Tomas-Kuchta-FPV/FOSSwheel/Assets/readme.md

# 3D assets

## Sources
https://grabcad.com/library/6-5-hoverboard-hubmotor-wheel-1/details?folder_id=5329696
https://grabcad.com/library/hoverboard-mainboard-1  
https://grabcad.com/library/5-connectors-xt60-male-female-cable-and-panel-mount-1
https://makerworld.com/en/models/2341987-xt90-panel-mount-unisex
