Tomas-Kuchta-FPV/FOSSwheel/PCB/readme.md

# OSHW 2ch VESC board

## Desing consideration
- High voltage ~55V
- Medium current ~20A
- Powered by VESC
- 2 channel
- CAN
- IMU
- Current measurement

I have ran out of time so I'm switching to hoverboard ESCs with a custom FW or you can still use DIY cheap FOCer, as a middle ground of bought and maker style.
