Tomas-Kuchta-FPV/FOSSwheel/Assets/Capture.PNG

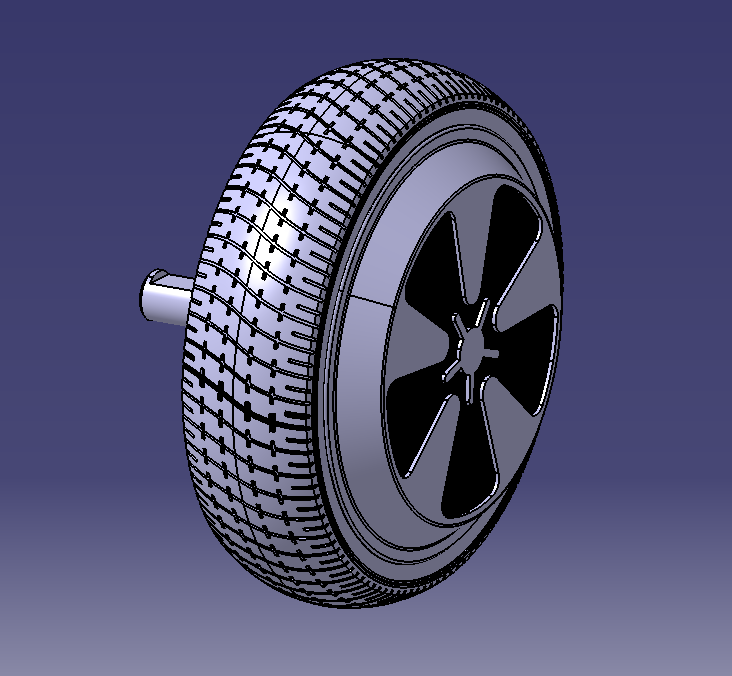
Assets/Capture.PNG
