Tomas-Kuchta-FPV/FOSSwheel/Cart/Aliexpress.png

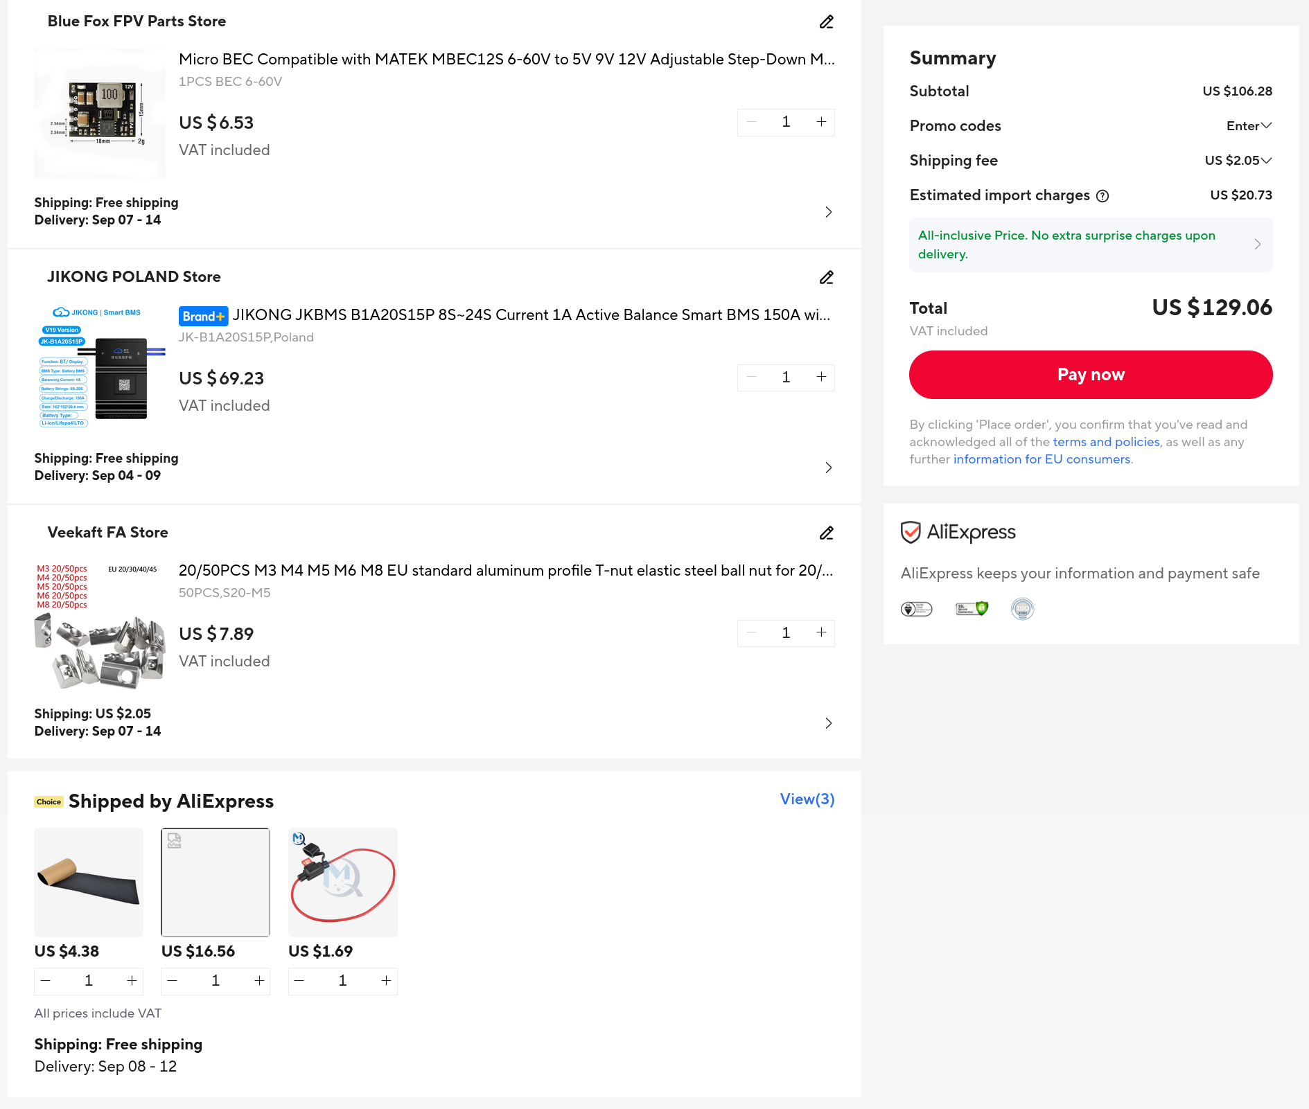
Cart/Aliexpress.png
