Tomas-Kuchta-FPV/FOSSwheel/Cart/big hobby.png

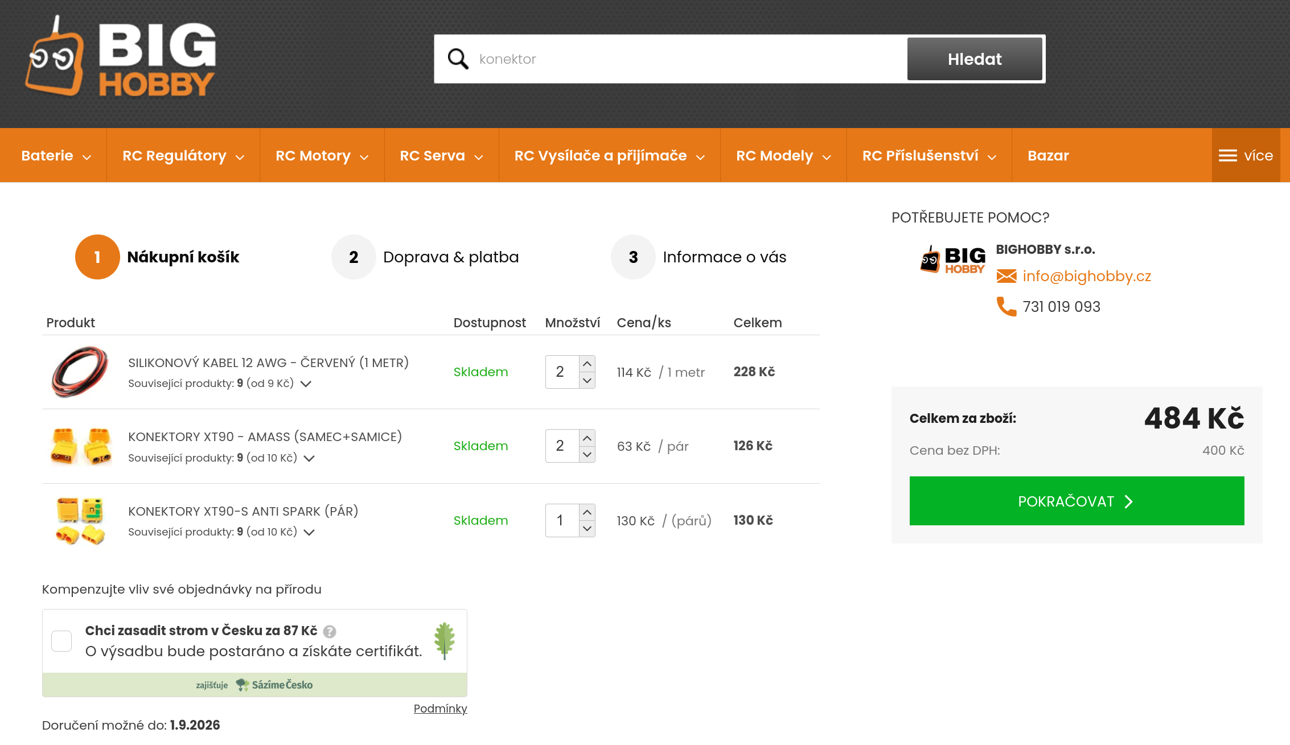
Cart/big hobby.png
