Tomas-Kuchta-FPV/FOSSwheel/Cart/ehlinik1.png

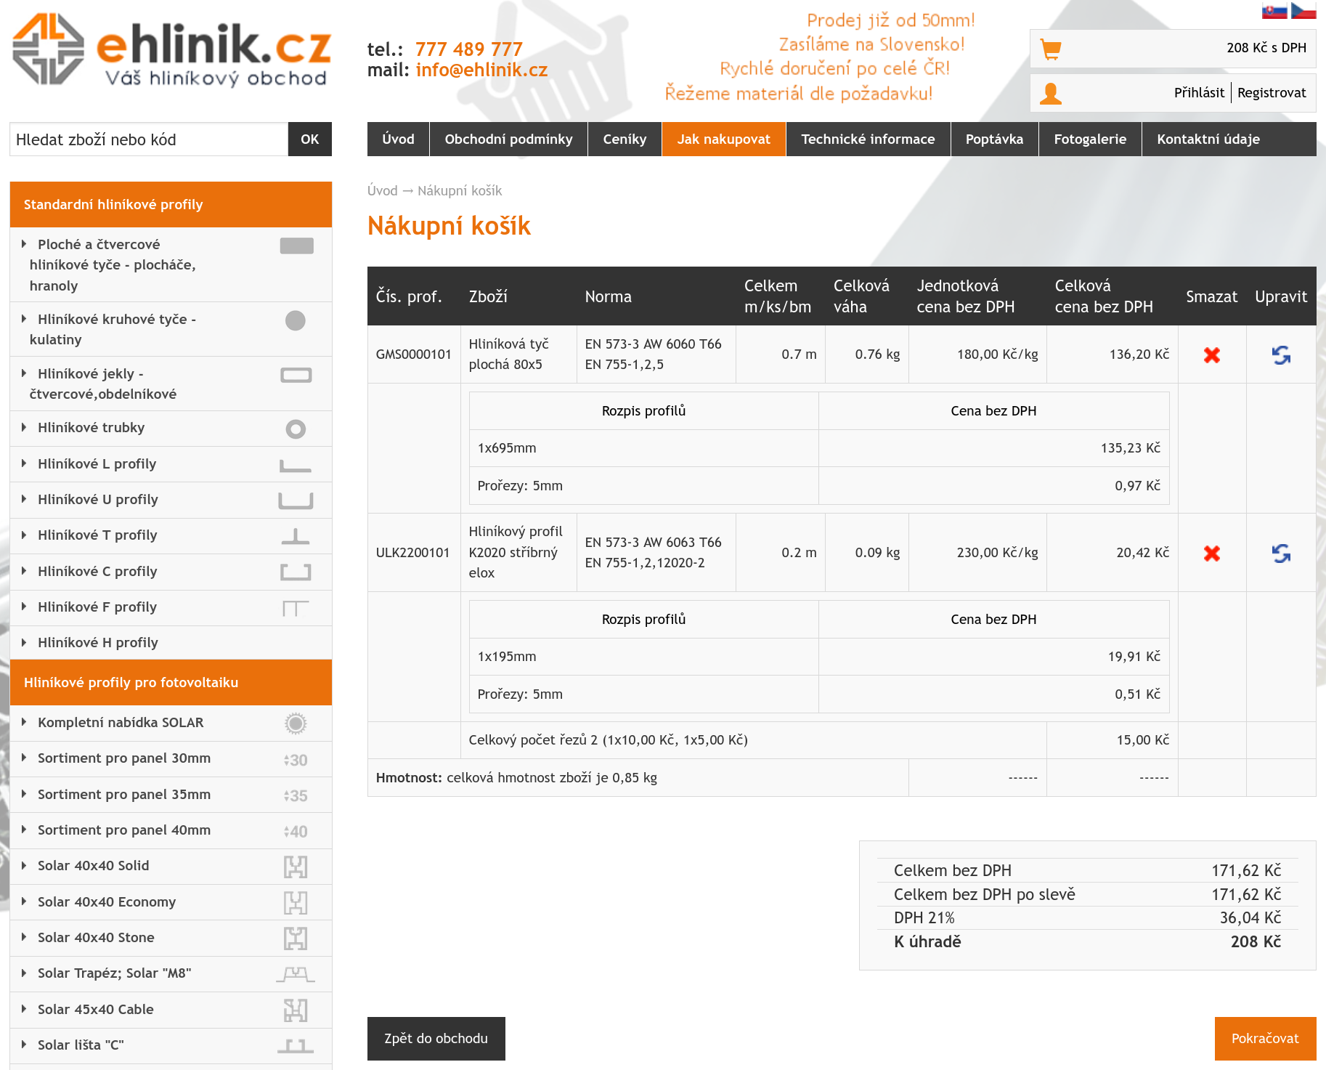
Cart/ehlinik1.png
