Tomas-Kuchta-FPV/FOSSwheel/Cart/ehlinik2.png

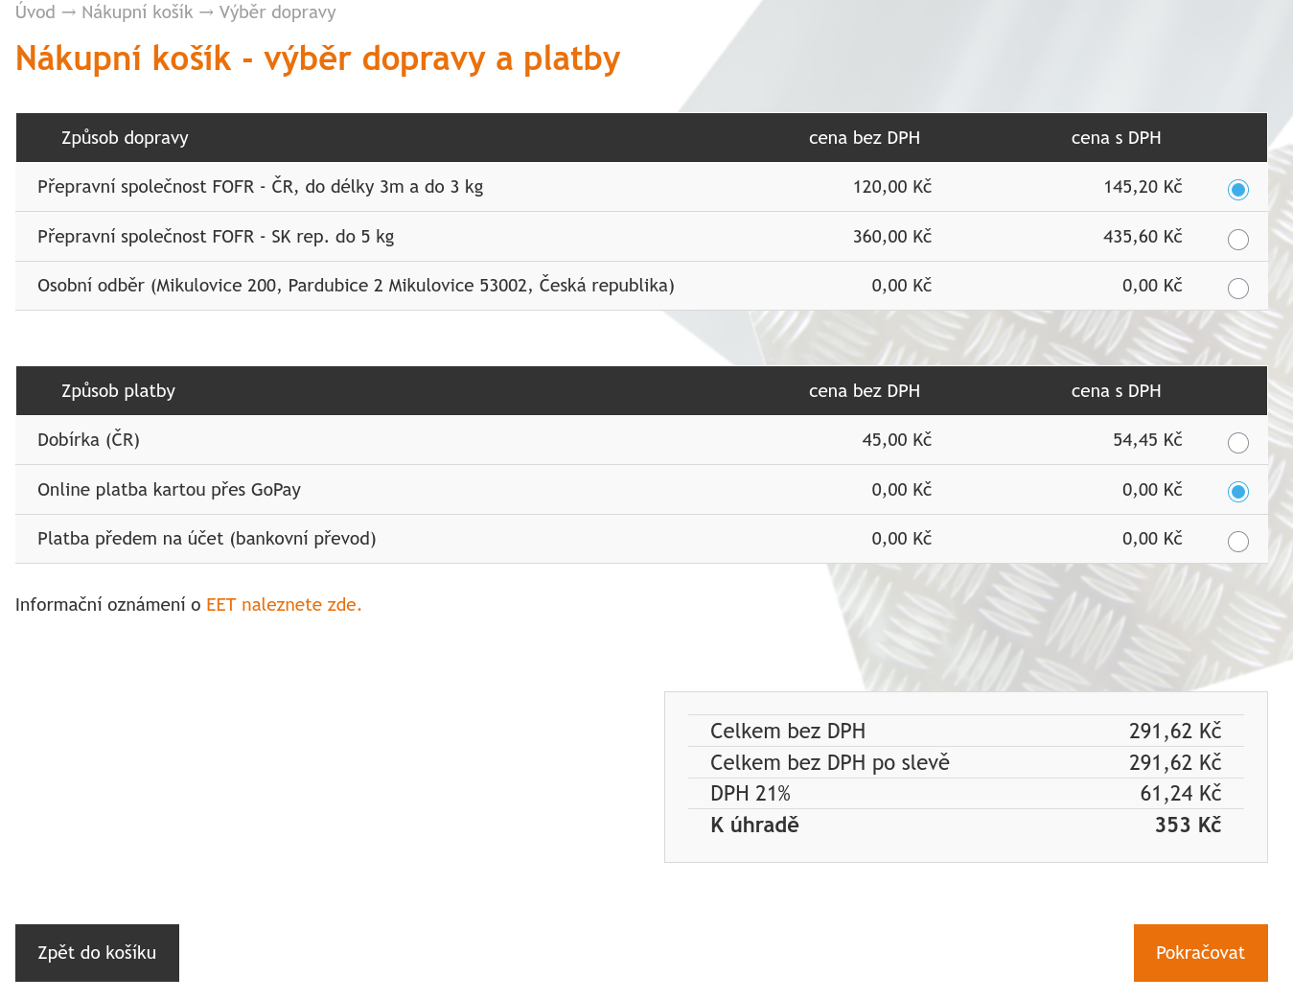
Cart/ehlinik2.png
