Tomas-Kuchta-FPV/FOSSwheel/Cart/JLCcnc.png

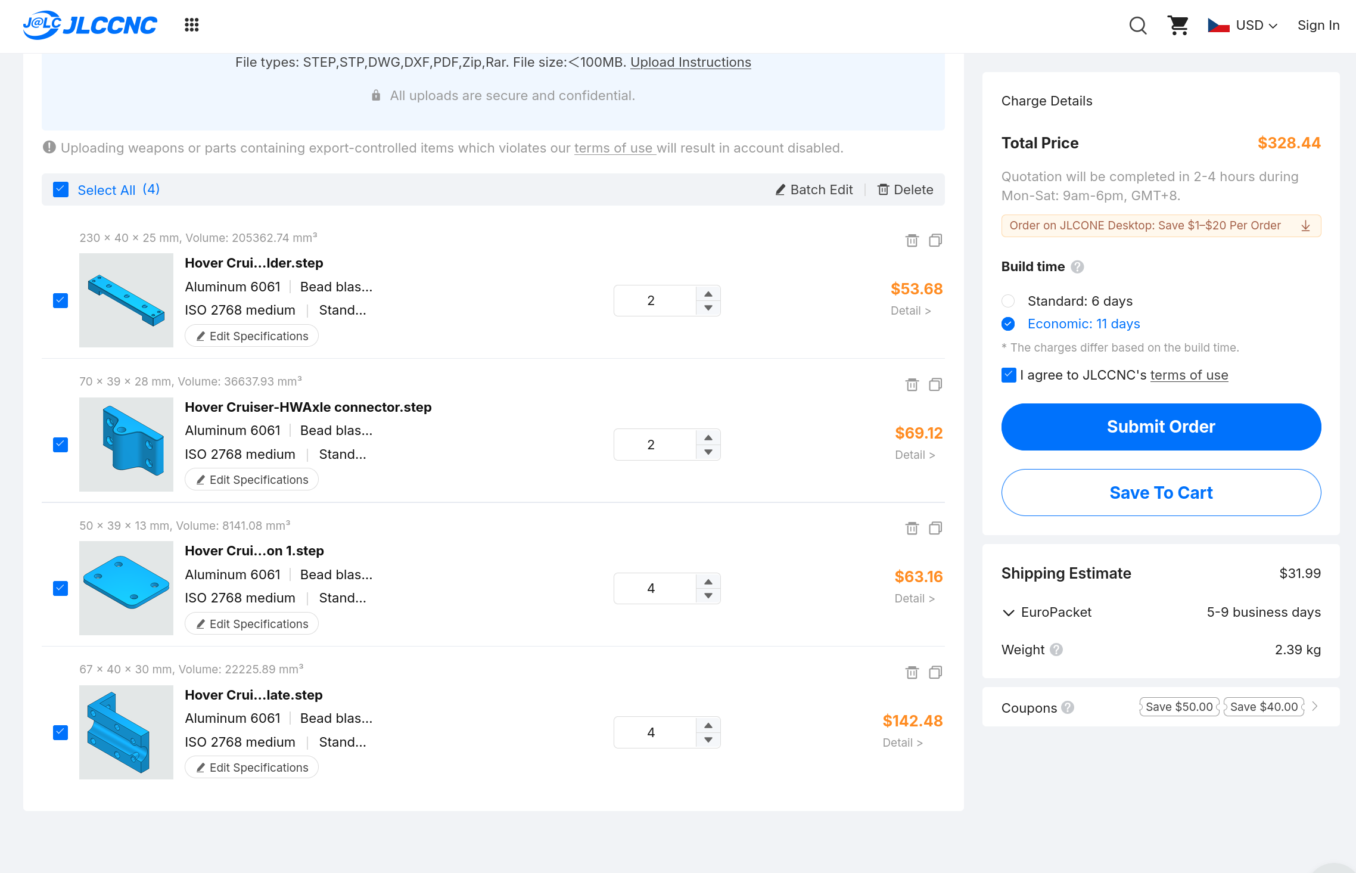
Cart/JLCcnc.png
