Tomas-Kuchta-FPV/FOSSwheel/Cart/vsk-profily.png

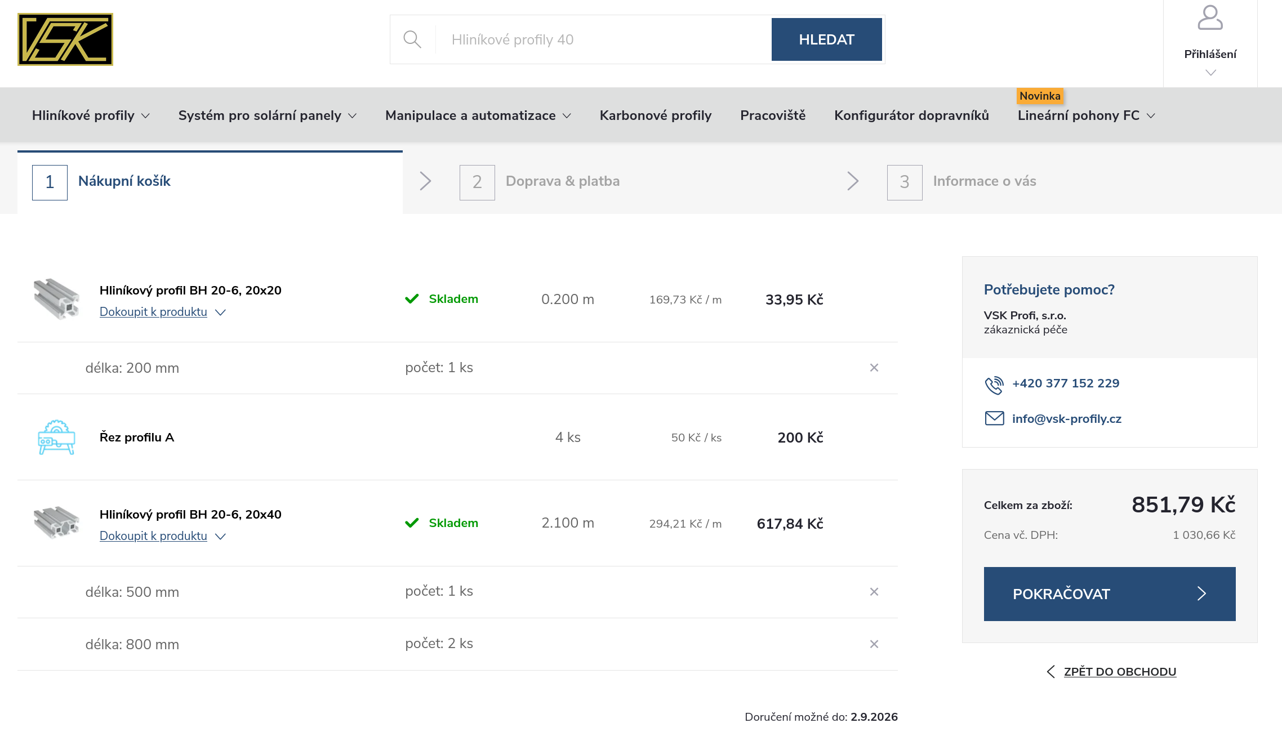
Cart/vsk-profily.png
