Tomas-Kuchta-FPV/FOSSwheel/Images/BoardTop-open deck.png

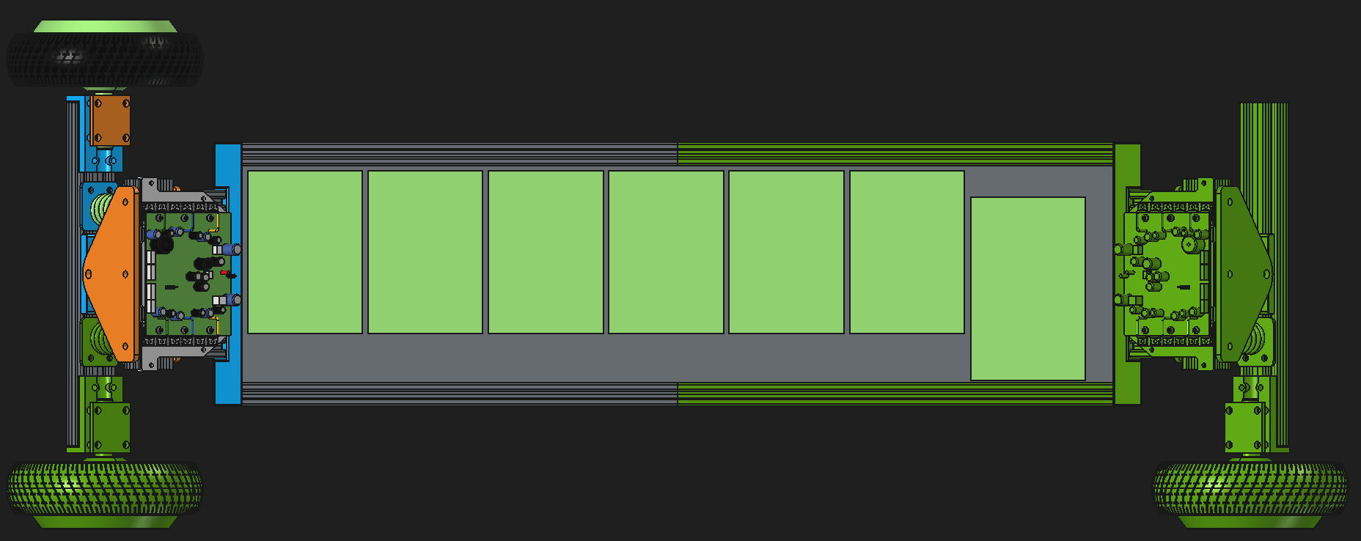
Images/BoardTop-open deck.png
