Tomas-Kuchta-FPV/FOSSwheel/Assets/hoverboard_motor_assembly.stp

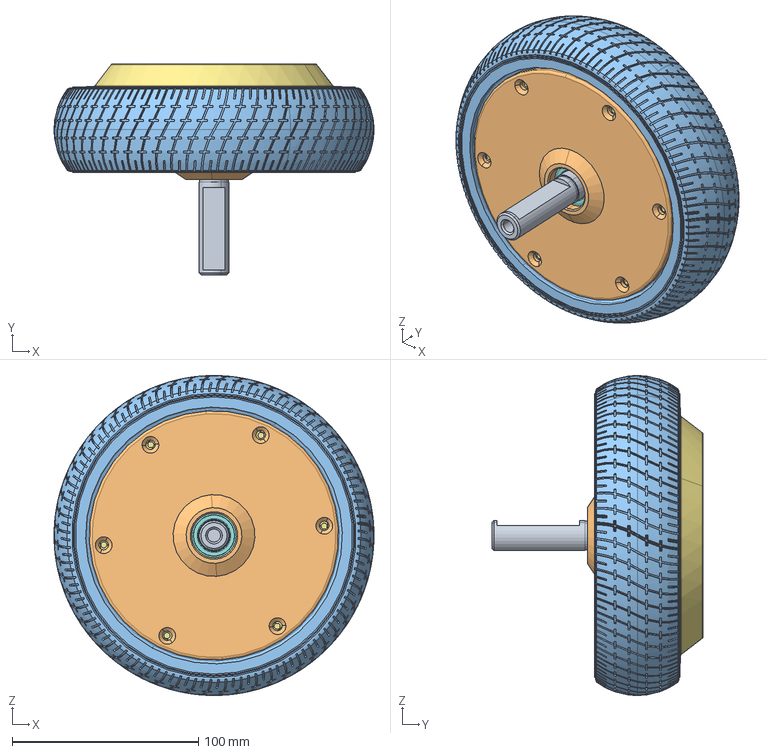
[picture p13: CAD file, 2026-08-16]
Assets/hoverboard_motor_assembly.stp
172.0 x 113.4 x 172.0 mm
