Tomas-Kuchta-FPV/FOSSwheel/Assets/XT90+Panel+Mount+(Conical).stl

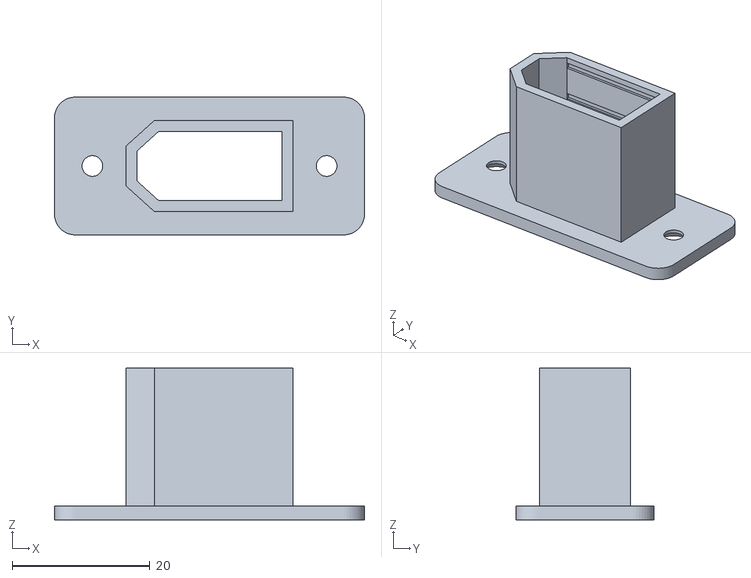
[picture p14: CAD file, 2026-08-30]
Assets/XT90+Panel+Mount+(Conical).stl
45.0 x 20.0 x 22.0
