Tomas-Kuchta-FPV/FOSSwheel/Hover Cruiser.FCStd

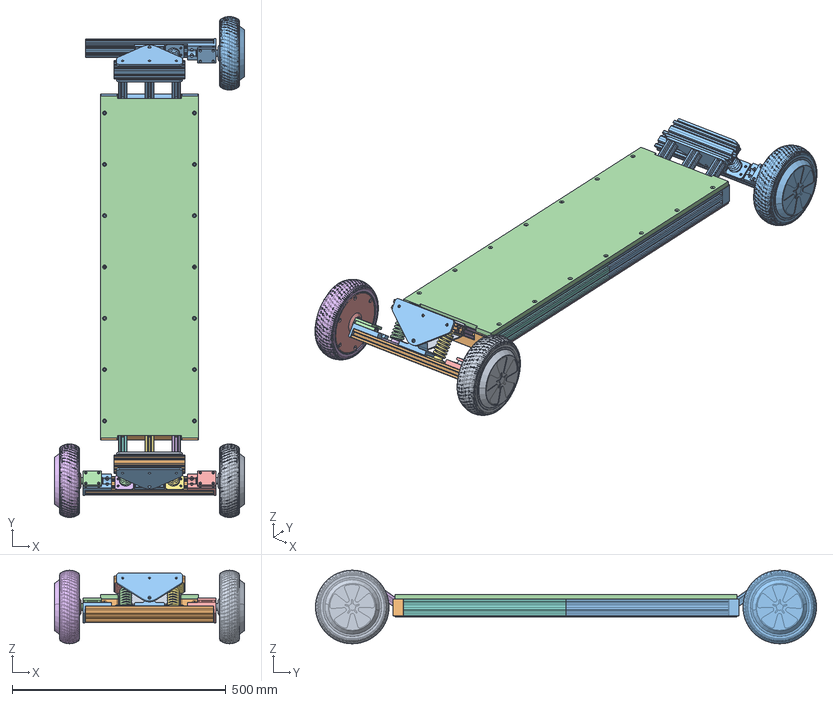
[picture p15: CAD file, 2026-08-27]
Hover Cruiser.FCStd
444.8 x 1171.6 x 172.0 mm
Hoverboard wheel 1 (Mirror #1)
Profile_20x40_008
Axle connector
axle
cover_plate
motor_bell
motor_bell001
motor_bell002
motor_bell003
motor_bell004
motor_bell005
motor_bell006
motor_bell007
motor_bell008
motor_bell009
motor_bell010
motor_bell011
motor_bell012
motor_bell013
motor_bell014
motor_bell015
motor_bell016
motor_bell017
motor_bell018
motor_bell019
motor_bell020
motor_bell021
motor_bell022
motor_bell023
motor_bell024
motor_bell025
motor_bell026
motor_bell027
motor_bell028
motor_bell029
motor_bell030
6003-2RS
6003-2RS001
6202-2RS
6202-2RS001
Wheel connecting plate
Wheel preasure plate
wheel connector (Mirror #3)
Profile_20x20_006
Profile_20x20_008
Profile_20x20_007
Axle holder plate 1
Profile_20x40_002
Axle Holder plate 2
spring 1
Spring retention 1
Spring retention 2
Spring assembly (Mirror #2)
Profile_20x40_006
Profile_20x40_007
base to wheels holder
HW (Mirror #4)
deck
bottom cover
