Tomas-Kuchta-FPV/FOSSwheel/Production/Hover Cruiser.3mf

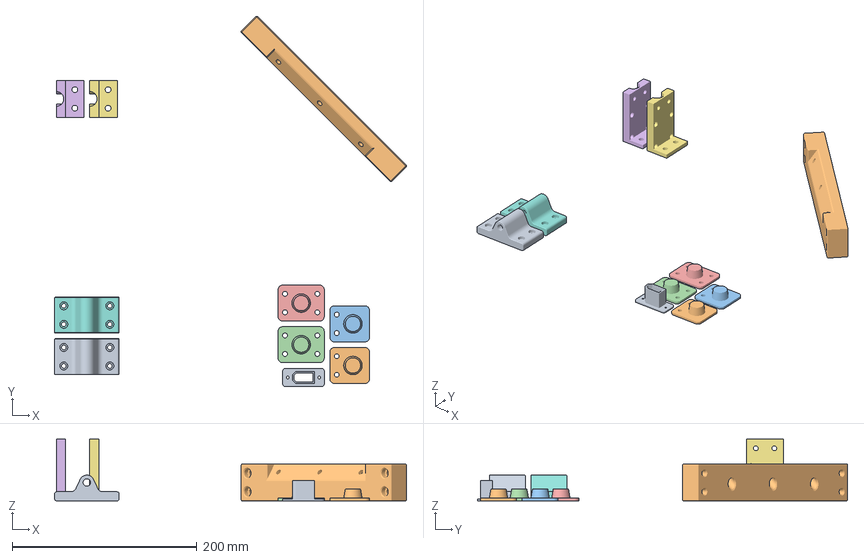
[picture p16: CAD file, 2026-08-30]
Production/Hover Cruiser.3mf
380.8 x 400.8 x 67.0 mm
XT90+Panel+Mount+(Conical).stl
Hover Cruiser-allSpring retention 2
Hover Cruiser-allSpring retention 1
Hover Cruiser-allWheel connecting plate
Hover Cruiser-allAxle connector
Hover Cruiser-allbase to wheels holder
