Tomas-Kuchta-FPV/FOSSwheel/Assets/XT60E_F.step

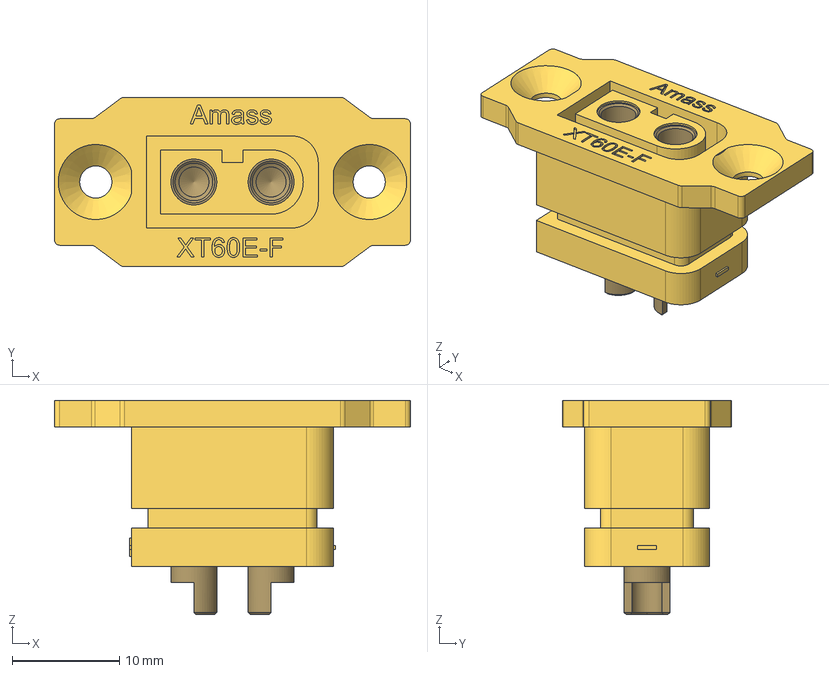
[picture p17: CAD file, 2026-08-30]
Assets/XT60E_F.step
33.2 x 15.8 x 20.0 mm
base
female001
female002
