Tomas-Kuchta-FPV/FOSSwheel/Production/Hover Cruiser-allAxle connector.step

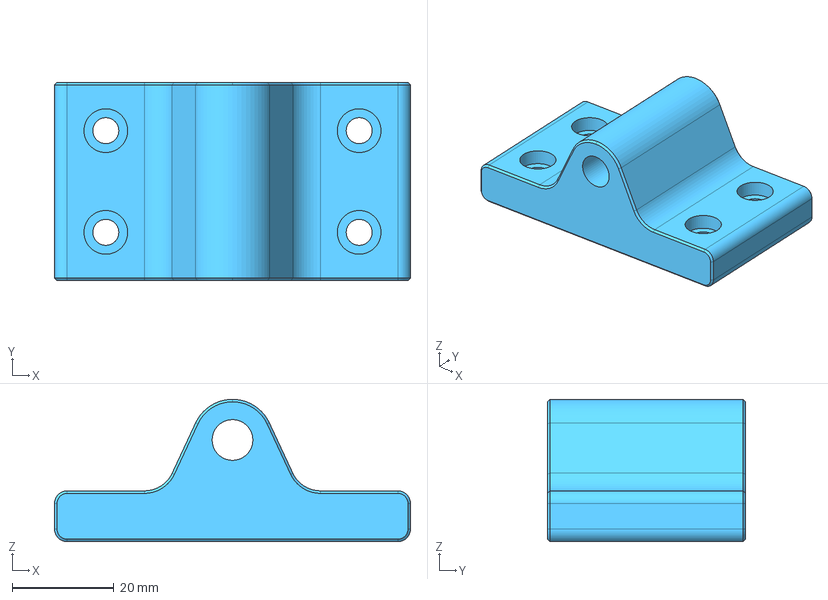
[picture p18: CAD file, 2026-08-30]
Production/Hover Cruiser-allAxle connector.step
70.0 x 39.0 x 28.0 mm
