Tomas-Kuchta-FPV/FOSSwheel/Assets/control_board.step

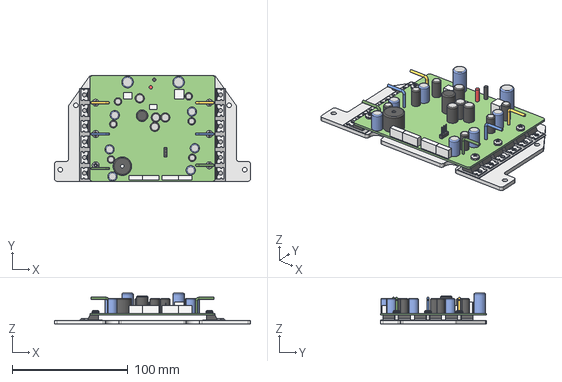
[picture p19: CAD file, 2026-08-28]
Assets/control_board.step
169.0 x 91.0 x 26.5 mm
