Tomas-Kuchta-FPV/FOSSwheel/Production/Hover Cruiser-allbase to wheels holder.step

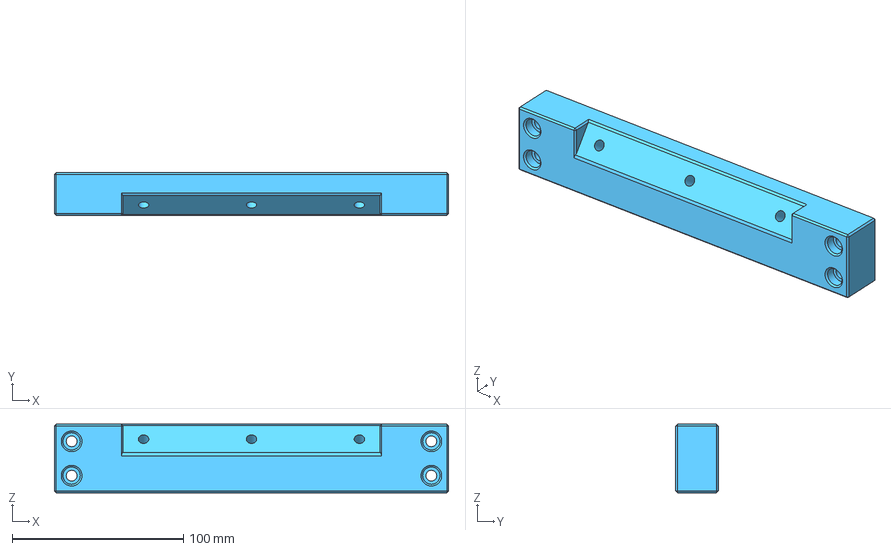
[picture p20: CAD file, 2026-08-30]
Production/Hover Cruiser-allbase to wheels holder.step
230.0 x 25.0 x 40.0 mm
