Tomas-Kuchta-FPV/FOSSwheel/Production/Hover Cruiser-allSpring retention 2.step

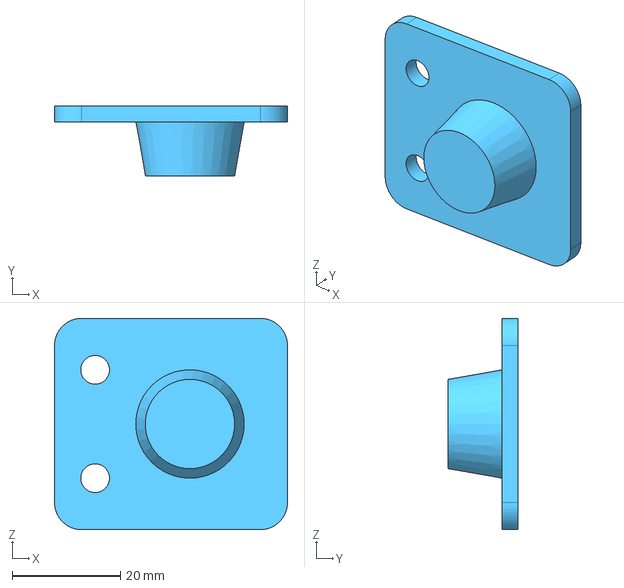
[picture p21: CAD file, 2026-08-30]
Production/Hover Cruiser-allSpring retention 2.step
43.0 x 13.0 x 39.0 mm
