Tomas-Kuchta-FPV/FOSSwheel/Production/Hover Cruiser-allSpring retention 1.step

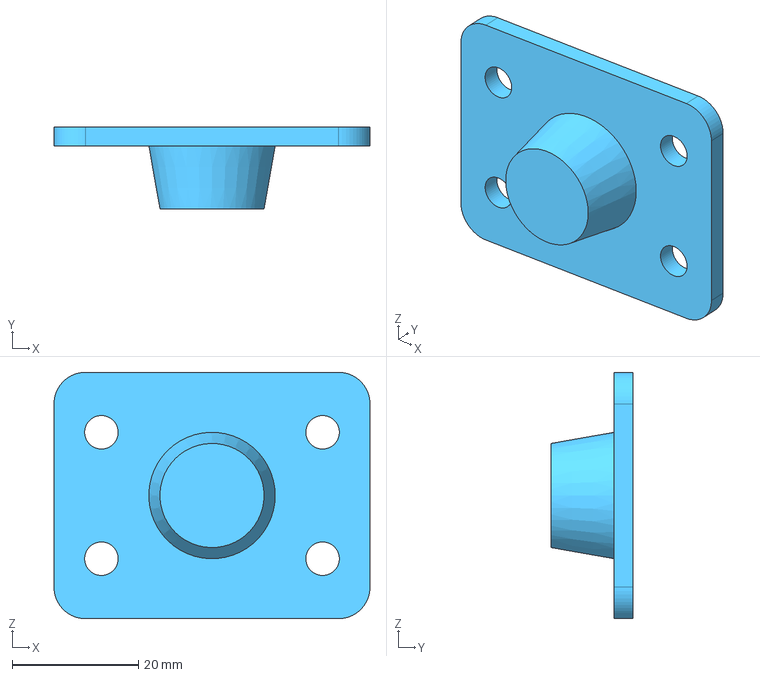
[picture p22: CAD file, 2026-08-30]
Production/Hover Cruiser-allSpring retention 1.step
50.0 x 13.0 x 39.0 mm
