Tomas-Kuchta-FPV/FOSSwheel/Production/Hover Cruiser-allWheel connecting plate.step

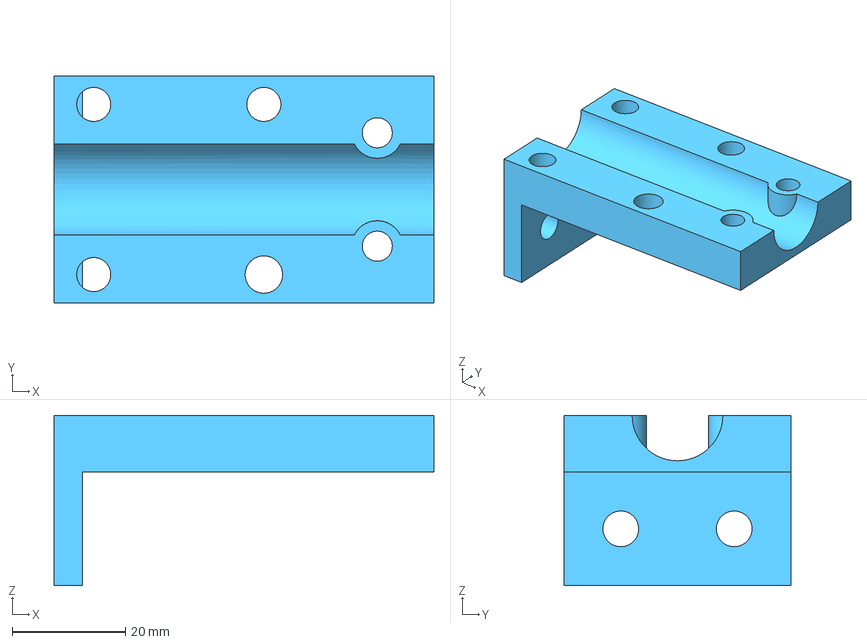
[picture p23: CAD file, 2026-08-30]
Production/Hover Cruiser-allWheel connecting plate.step
67.0 x 40.0 x 30.0 mm
