Tomas-Kuchta-FPV/FOSSwheel/assembly.md

# How to assemble this

## the onw most important wheel
https://www.youtube.com/watch?v=i5fHTRAW_RI  
https://makerworld.com/en/models/1315006-hoverboard-motors-mounting-kit-to-gokart-tire#profileId-1349937
