Tomas-Kuchta-FPV/FOSSwheel/TODO.md

V0
- [ ] CAD
  - [x] Tucks axle should be at ~~45deg~~ 30deg
  - [x] Stiffener in the middle
- [x] BOMs
V2
- [ ] Suspension
- [ ] Removable battery
- [ ] waterproof
