Tomas-Kuchta-FPV/FOSSwheel/Assets/91280A548_Medium-Strength Class 8.8 Steel Hex Head Screw.pdf

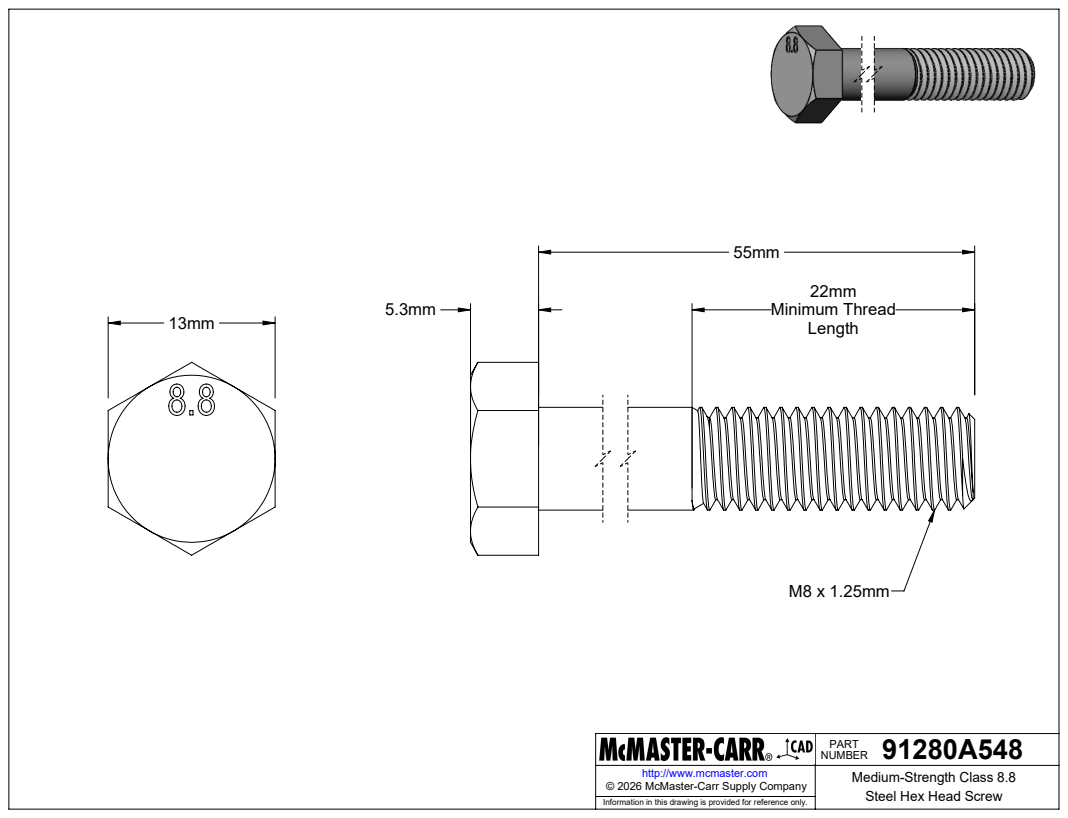
[picture p24: page 1]
Minimum Thread

91280A548 PART NUMBER

http://www.mcmaster.com | Medium-Strength Class 8.8 Steel Hex Head Screw © 2026 McMaster-Carr Supply Company

Information in this drawing is provided for reference only.
