Tomas-Kuchta-FPV/FOSSwheel/Assets/91290A316_Black-Oxide Alloy Steel Socket Head Screw.pdf

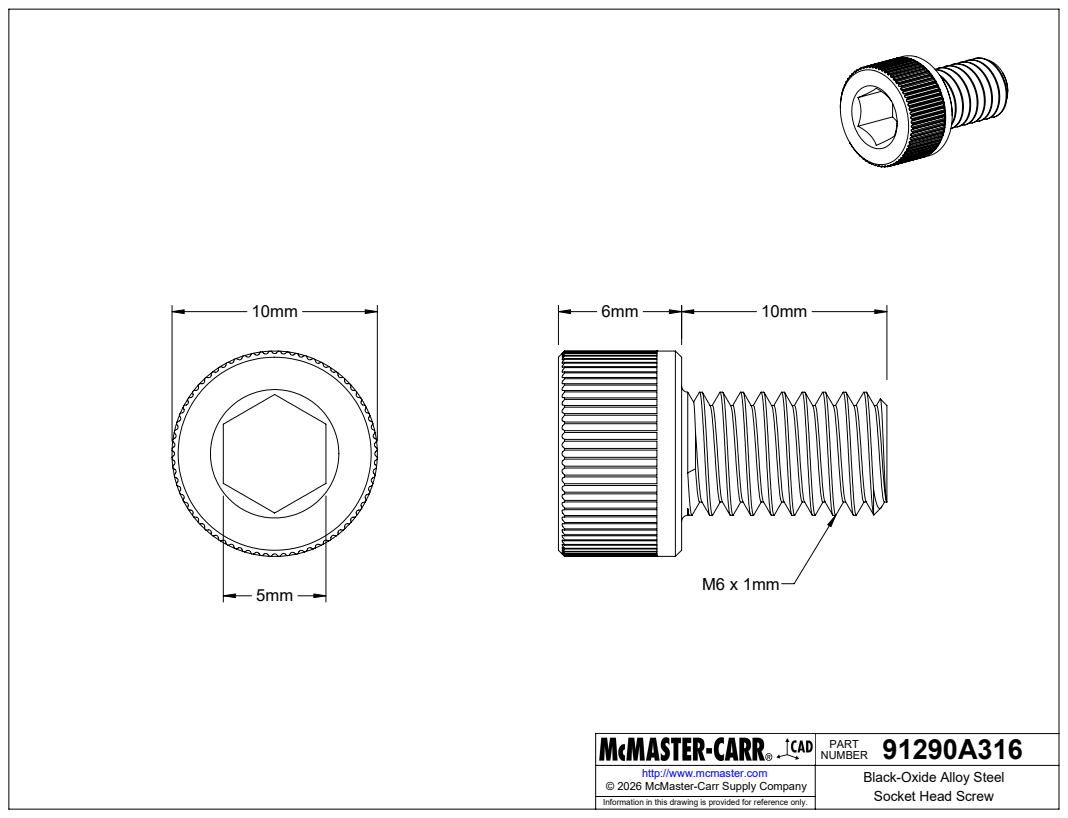
[picture p25: page 1]

91290A316 PART NUMBER

http://www.mcmaster.com | Black-Oxide Alloy Steel Socket Head Screw © 2026 McMaster-Carr Supply Company

Information in this drawing is provided for reference only.
