Tomas-Kuchta-FPV/FOSSwheel/Production/Drawings.pdf

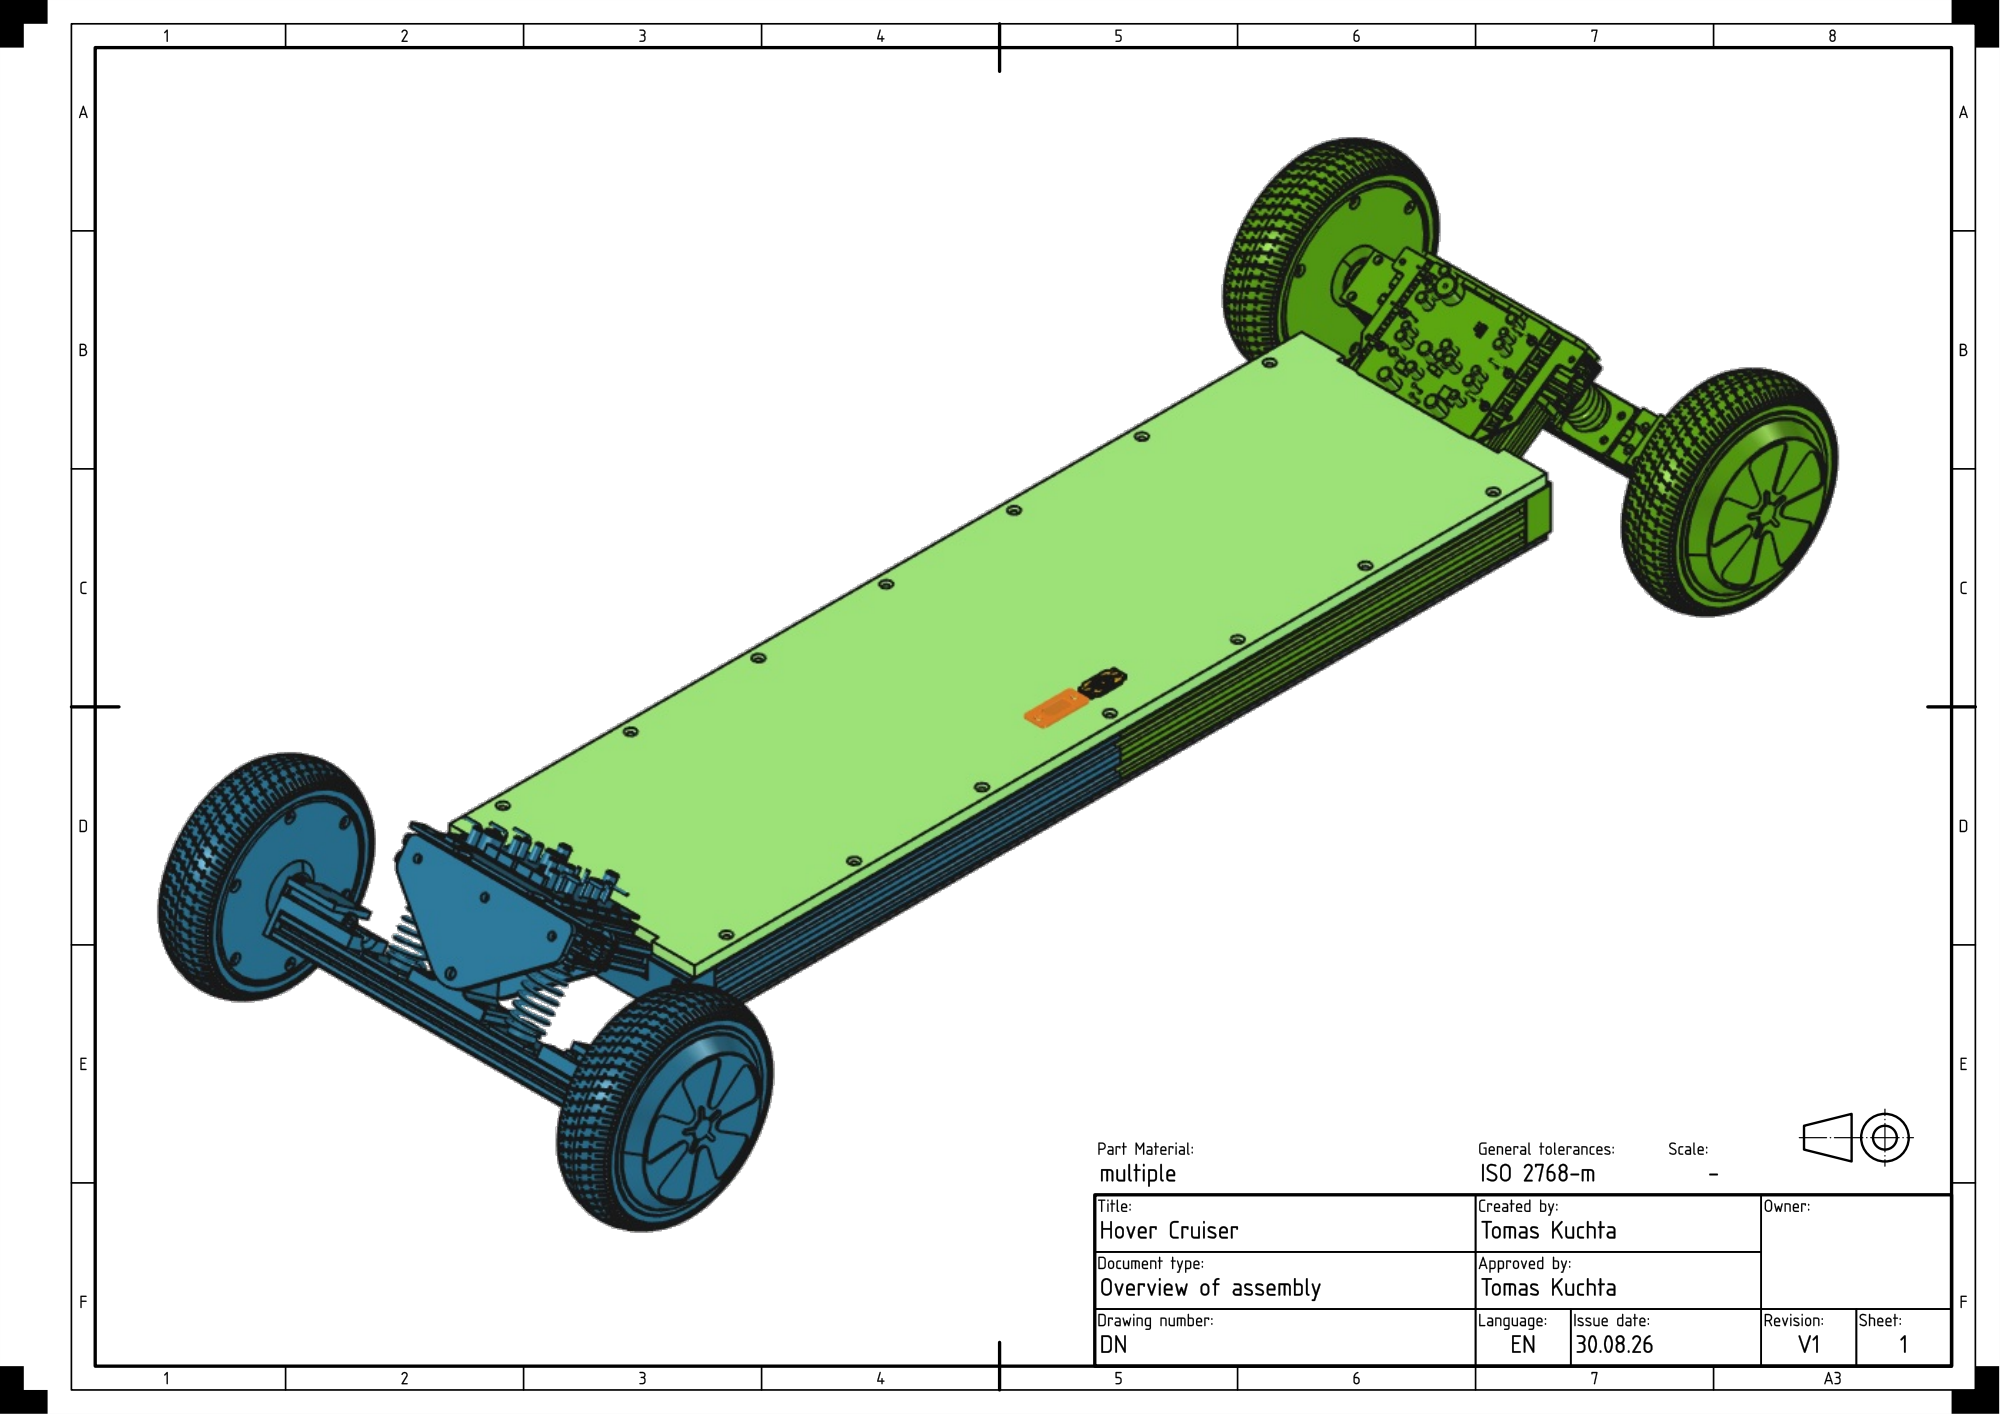
[picture p26: page 1]

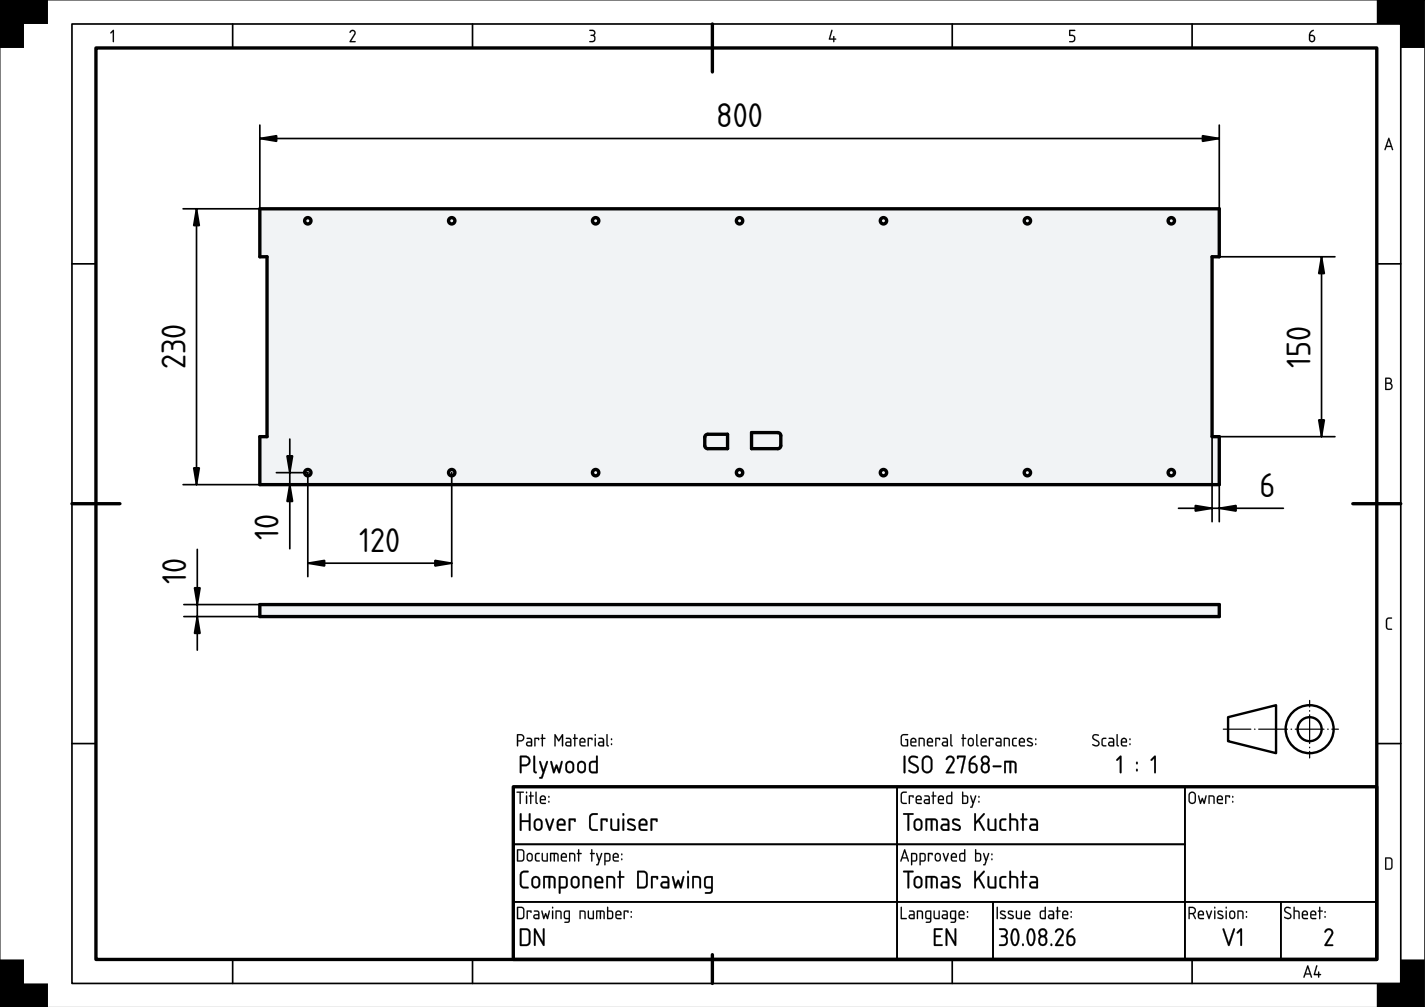
[picture p27: page 2]

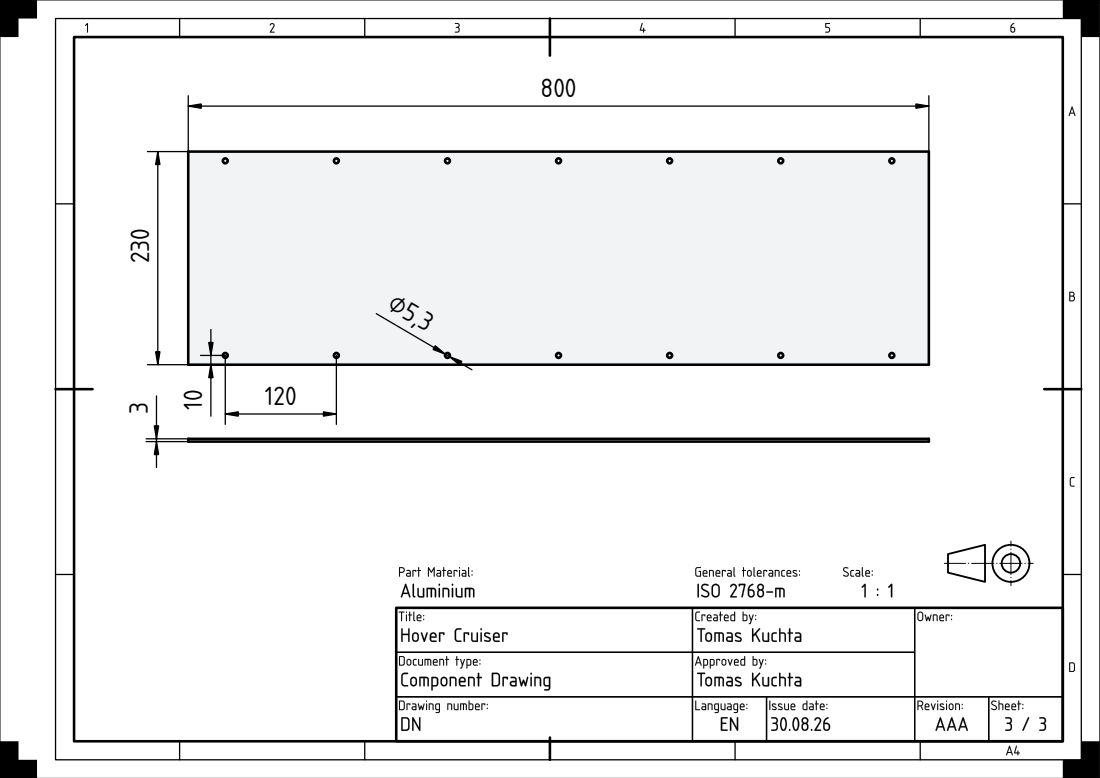
[picture p28: page 3]

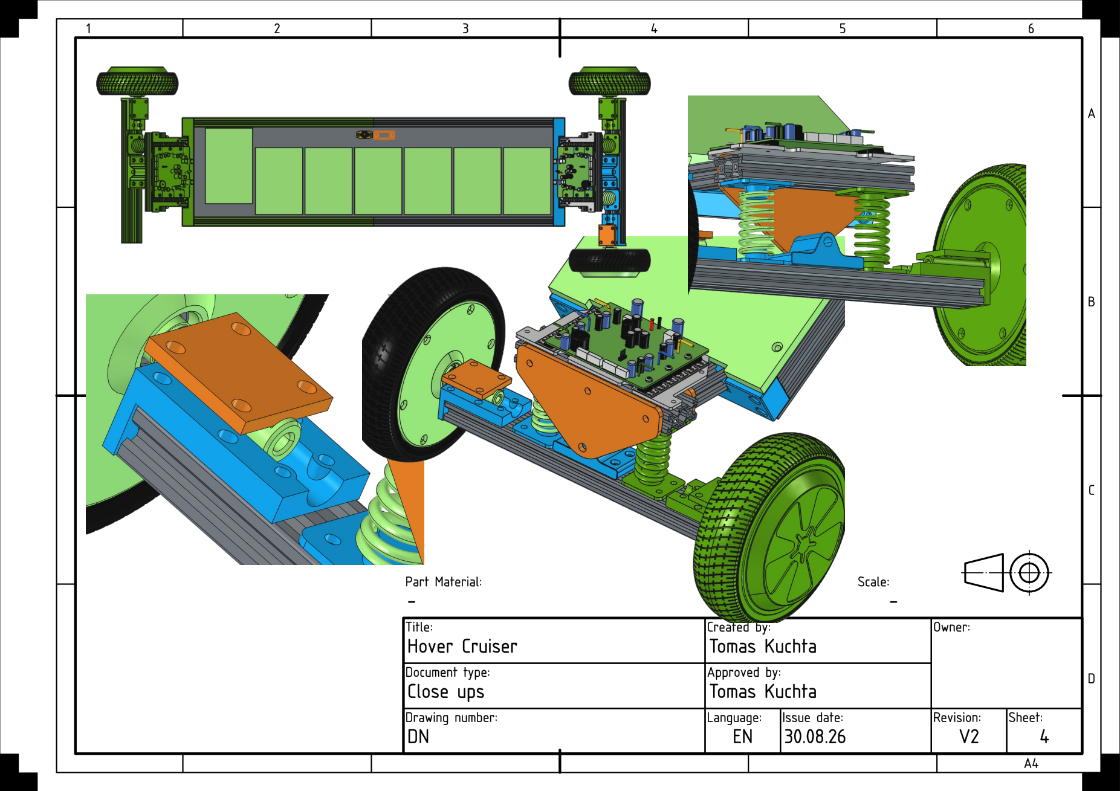
[picture p29: page 4]

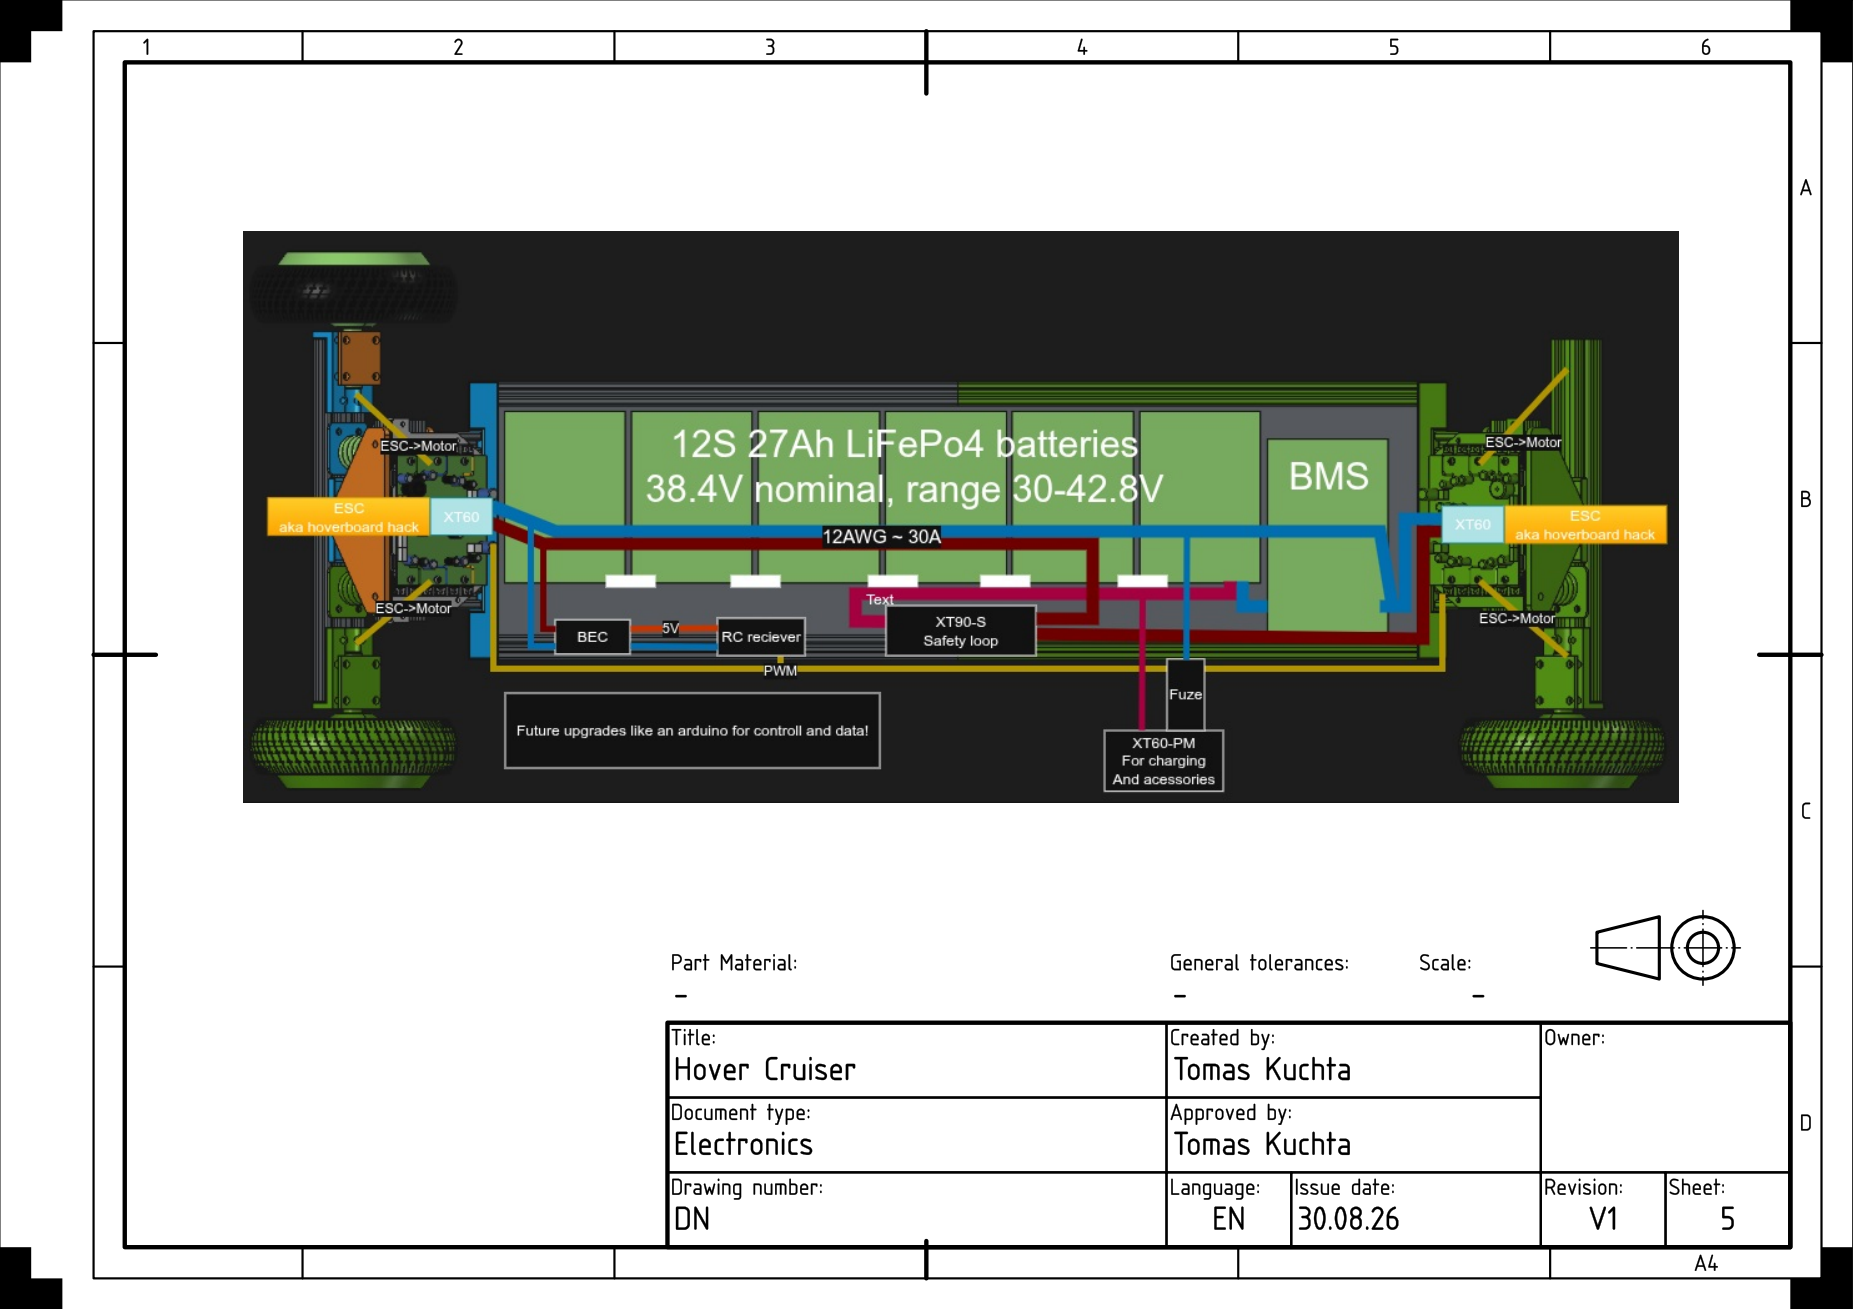
[picture p30: page 5]
