Tomas-Kuchta-FPV/FOSSwheel/(commit log)

2026-08-16 started work
    [BOM.csv, FOSSwheelCAD.FCStd, Mid+spacer+86mm+++templates.3mf, RG Go-Kart Wheel 11X710-6.igs, V-Slot 20x40.dxf, hoverboard_motor_assembly.stp]
2026-08-20 Pivot to a long board FOSSwheel -> FOSSboard.
2026-08-24 First prototype - WiP
    [FOSSboard.FCStd, hoverboard_motor_assembly.stp, main BOM.ods]
2026-08-27 finished the board
    [FOSSboard.FCStd, Hover Cruiser.FCStd, main BOM.ods]
2026-08-27 added the cheap focer escs to the mix. Am I going insane rn.
    [main BOM.ods]
2026-08-28 the CAD model seems to be complete and a few thweaks to the repo
    [Extrusion cutlist.ods, control_board.step, main BOM.ods]
2026-08-28 I cant CAD
2026-08-28 drew a schematic
2026-08-30 a bit of everything - finishing to ship to stardance
    [Extrusion cutlist.ods, Hover Cruiser-allAxle connector.step, Hover Cruiser-allSpring retention 1.step, Hover Cruiser-allSpring retention 2.step, Hover Cruiser-allWheel connecting plate.step, Hover Cruiser-allbase to wheels holder.step, Hover Cruiser.3mf, XT60E_F.step]
2026-08-30 added BOM
    [BOM.csv]
